lnls-ima/si-wls/model-08/simulation/magnetic/integrals-and-multipoles/mesh/Difference_trajectory_in-axis_field2_Xi=0mm_newmesh_.JPG

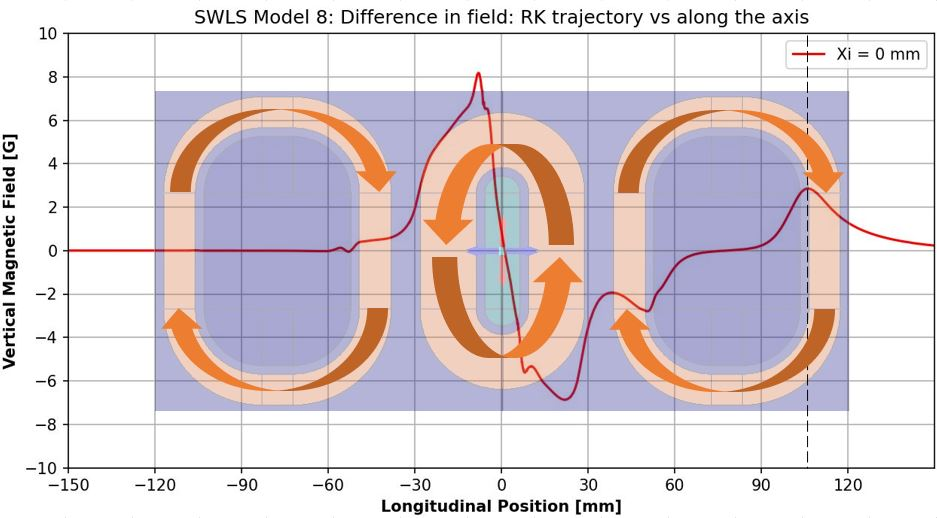
model-08/simulation/magnetic/integrals-and-multipoles/mesh/Difference_trajectory_in-axis_field2_Xi=0mm_newmesh_.JPG
