lnls-ima/si-wls/vertical-cryostat-prototypes/simulation/magnetic/geometry_prototype_centralcoil.PNG

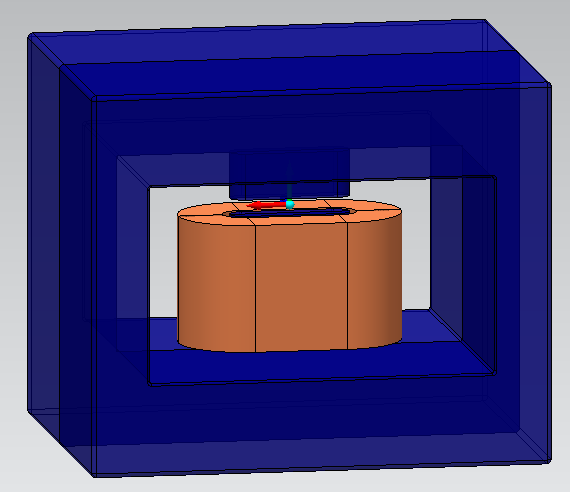
vertical-cryostat-prototypes/simulation/magnetic/geometry_prototype_centralcoil.PNG
