lnls-ima/si-wls/model-01/simulation/magnetic/SWLS_Sirius_Model1_Long_Field_I=260A.png

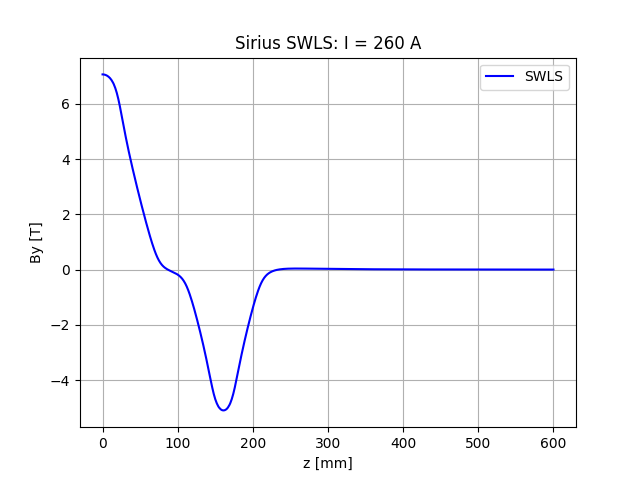
model-01/simulation/magnetic/SWLS_Sirius_Model1_Long_Field_I=260A.png
