lnls-ima/si-wls/model-02/simulation/magnetic/long_field_SWLS_Model2.JPG

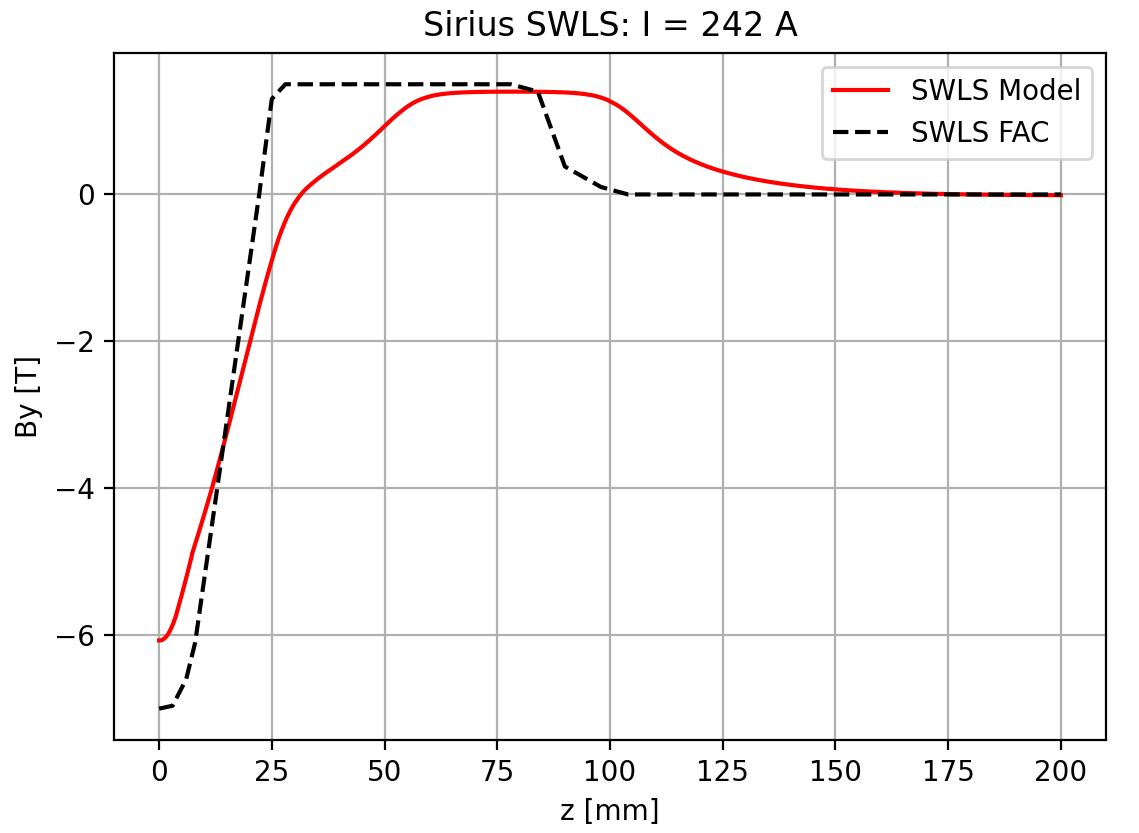
model-02/simulation/magnetic/long_field_SWLS_Model2.JPG
