lnls-ima/si-wls/vertical-cryostat-prototypes/simulation/magnetic/figures/field_prototype_centralcoil_current.PNG

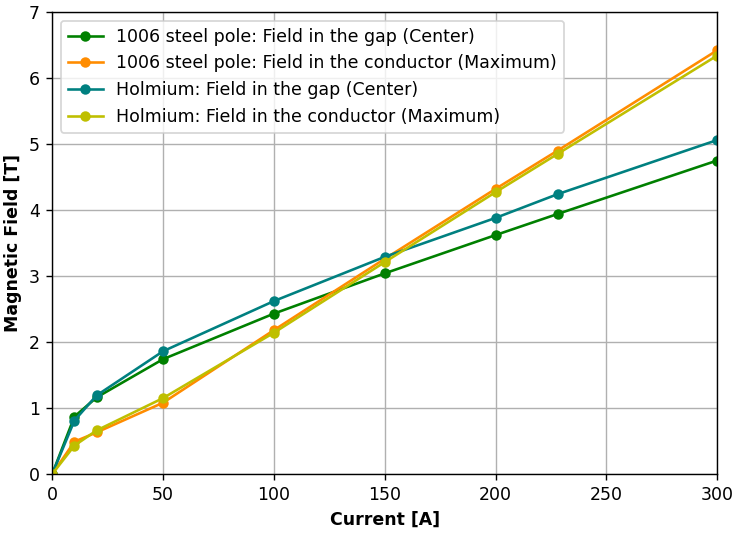
vertical-cryostat-prototypes/simulation/magnetic/figures/field_prototype_centralcoil_current.PNG
