lnls-ima/si-wls/vertical-cryostat-prototypes/simulation/magnetic/figures/field_prototype_sidecoil.PNG

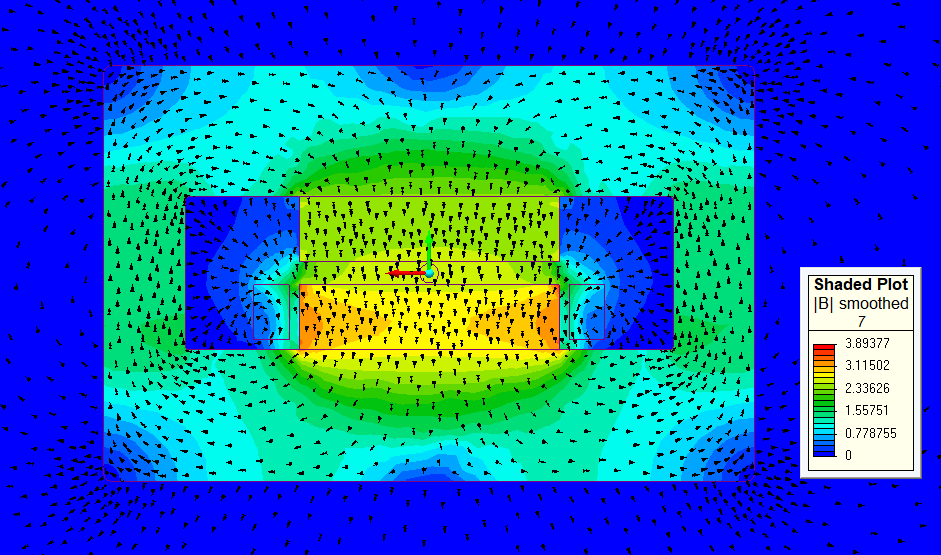
vertical-cryostat-prototypes/simulation/magnetic/figures/field_prototype_sidecoil.PNG
