lnls-ima/si-wls/vertical-cryostat-prototypes/simulation/magnetic/figures/margin_prototype_centralcoil.PNG

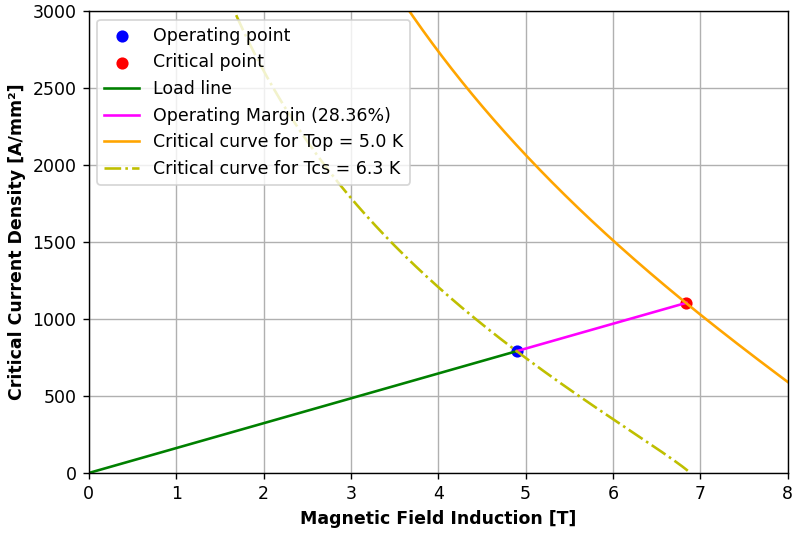
vertical-cryostat-prototypes/simulation/magnetic/figures/margin_prototype_centralcoil.PNG
