lnls-ima/si-wls/vertical-cryostat-prototypes/simulation/magnetic/figures/margin_prototype_sidecoil.PNG

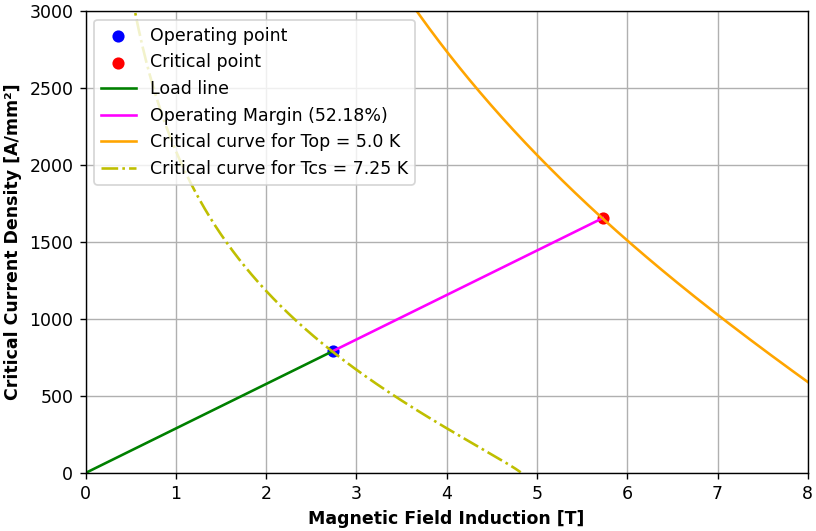
vertical-cryostat-prototypes/simulation/magnetic/figures/margin_prototype_sidecoil.PNG
