lnls-ima/si-wls/vertical-cryostat-prototypes/simulation/magnetic/figures/sme_inductance_prototype_sidecoil.PNG

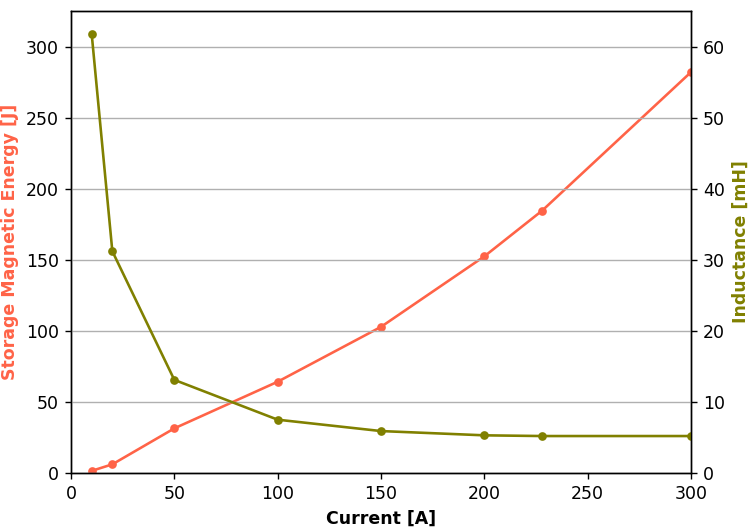
vertical-cryostat-prototypes/simulation/magnetic/figures/sme_inductance_prototype_sidecoil.PNG
