lnls-ima/si-wls/vertical-cryostat-prototypes/simulation/magnetic/geometry_prototype_sidecoil.PNG

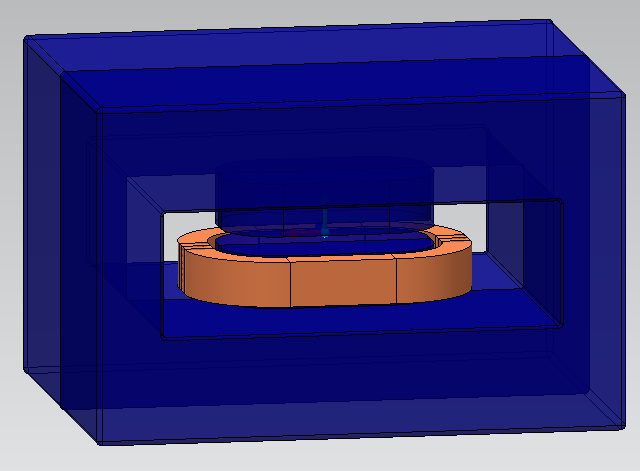
vertical-cryostat-prototypes/simulation/magnetic/geometry_prototype_sidecoil.PNG
