lnls-ima/si-wls/model-02/simulation/magnetic/SWLS_Sirius_Model2.step

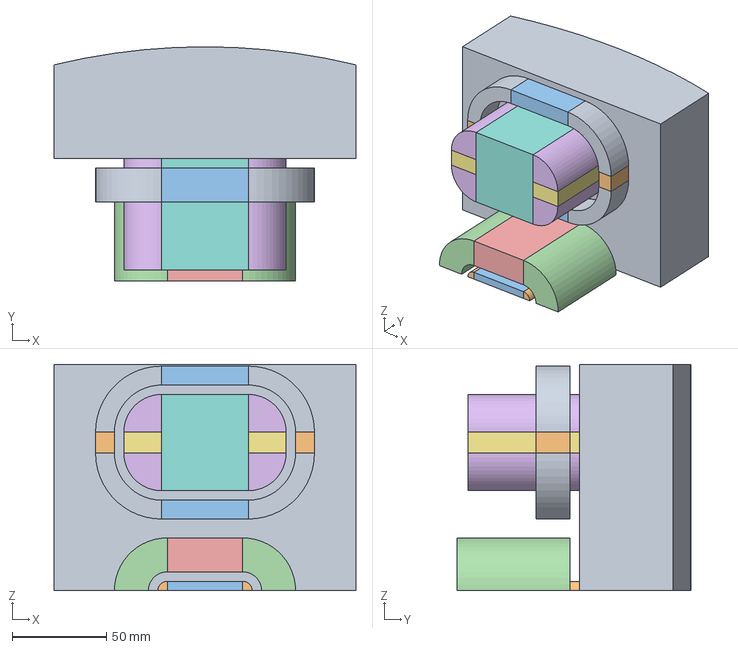
[picture p14: CAD file, 2021-10-20]
model-02/simulation/magnetic/SWLS_Sirius_Model2.step
160.0 x 124.2 x 120.0 mm
