lnls-ima/si-wls/vertical-cryostat-prototypes/simulation/magnetic/2023-02-24_SWLS_Prototype_CentralCoil_Holmium_Results.txt

I[A]	Bp[T]	Bc[T]	Fc[N]	SME[J]	L[mH]
0	0.0	0.0	0.0	0.0	0.0
10	0.81	0.43	-103	7.2	78.9
20	1.19	0.66	-230	16.4	59.5
50	1.86	1.15	-966	71.2	47.6
100	2.62	2.14	-2880	238	43.3
150	3.29	3.21	-5340	502	41.7
200	3.88	4.27	-7940	862	40.6
228	4.24	4.85	-9420	1106	40.2
300	5.06	6.34	-13120	1858	39.2
