lnls-ima/si-wls/vertical-cryostat-prototypes/simulation/magnetic/2023-02-24_SWLS_Prototype_CentralCoil_Results.txt

I[A]	Bp[T]	Bc[T]	Fc[N]	SME[J]	L[mH]
0	0.0	0.0	0.0	0.0	0.0
10	0.87	0.49	-93	4.7	53.8
20	1.16	0.63	-208	12.2	47.7
50	1.74	1.08	-808	58.4	43.7
100	2.43	2.18	-2320	218	41.9
150	3.04	3.26	-5020	476	40.8
200	3.62	4.32	-7560	830	39.9
228	3.94	4.90	-9000	1066	39.5
300	4.75	6.42	-12640	1806	38.4
