lnls-ima/si-wls/vertical-cryostat-prototypes/simulation/magnetic/2023-02-24_SWLS_Prototype_SideCoil_Results.txt

I[A]	Bp[T]	Bc[T]	Fc[N]	SME[J]	L[mH]
0	0.0	0.0	0.0	0.0	0.0
10	0.32	0.19	-23.6	1.5	61.8
20	0.64	0.38	-94.6	6.1	31.2
50	1.47	0.85	-512	31.4	13.1
100	2.06	1.20	-1156	64.2	7.5
150	2.37	1.50	-2000	102.8	5.9
200	2.61	1.83	-2980	152.4	5.3
228	2.74	2.00	-3580	184.6	5.2
300	3.02	2.46	-5220	282.0	5.2
