lnls-ima/si-wls/model-09/simulation/magnetic/2023-01-30_SWLS_Sirius_Model9.0_Results_I=228A.txt

Bp [T]		Bmax [T]	Margin [%]	HFIntBy [T.cm]
-6,6337		5,2832		24,2		-20,29
