lnls-ima/si-wls/model-08/simulation/magnetic/2022-06-03_SWLS_Sirius_Model8_Results_I=228A.txt

Bp [T]		Bmax [T]	Margin [%]	HFIntBy [T.cm]
-6,3229		5,2945		24,04		-19,78
