lnls-ima/si-wls/model-02/simulation/magnetic/2021-10-14_SWLS_Sirius_Model2_Results_I=242A.txt

Bp [T]		Bmax [T]	Margin [%]	FWHM [mm]
-6.0715		5.1781		21.31		31.8
