lnls-ima/si-wls/model-09/simulation/magnetic/updated-BHcurves/spectra-results/OPT-results/2024-05_SWLS_Flux_1x1mrad2.png

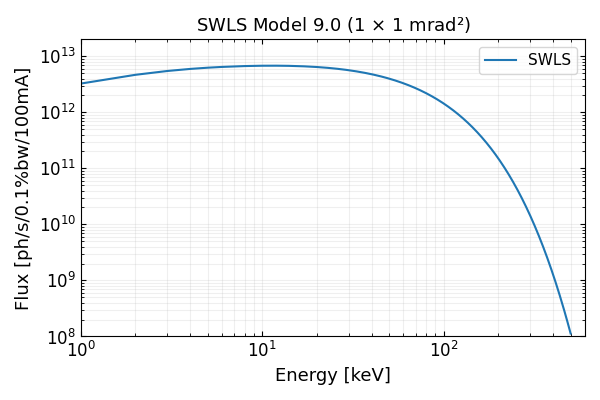
model-09/simulation/magnetic/updated-BHcurves/spectra-results/OPT-results/2024-05_SWLS_Flux_1x1mrad2.png
