lnls-ima/si-wls/model-06/simulation/spice/extraction/extraction_circuit_full_magnet_validation_time_ramp_up.asc

A1: diffschmtbuf; Vt=100m, Vh=1m, Vhigh=1, Vlow=0, Trise=1n, Tfall=1n
A2: srflop; Vhigh=1, Td=50m
A3: srflop; Vhigh=1, Td=33.3333m
A5: srflop; Vhigh=1, Td=1m
D1: diode; Dideal
D2: diode; Dlim
I1: current; PULSE(0 240 0 300 0 10)
IRq: current; 1
L_lower_left: ind; {Lside}; Rser=0 Rpar=0
L_lower_main: ind; {Lmain}; Rser=0 Rpar=0
L_lower_right: ind; {Lside}; Rser=0 Rpar=0
L_upper_left: ind2; {Lside}; Rser=0 Rpar=0
L_upper_main: ind; {Lmain}; Rser=0 Rpar=0
L_upper_right: ind; {Lside}; Rser=0 Rpar=0
R_lower_left: res; 0
R_lower_main: res; 0
R_lower_right: res; 0
R_upper_left: res; 0
R_upper_main: res; 0
R_upper_right: res; 0
Rdump1: res; 1.25
Rdump2: res; 1.25
S1: sw; MYSW
V1: voltage; 0.1
V2: voltage; 10
VRquench: voltage; PULSE(1u 20m 10m 150m 1 5)
Named nets: 0, Rquench, PSdelay, SWdelay, Qtrigger, Vdetp, Vdetn, Vthres, Vmagnetp, Vmagnetn, Vpsoutp, Qdet, VT1, VR2-3, VT3, VR3-4, VT4, VR4-5, VT5, VR5-6, VT6, VR6-7, VT7, VT2, VR1-2
.tran 310
.ic I(L1)=240 I(L2)=240
.model MYSW SW(Vt=0.9, Vh=1u, Ron=1000G, Roff=1u)
.model Dideal D(Ron=1u, Roff=1000G, Vfwd=1)
.model Dlim D(Ron=1u, Roff=1000G, Vfwd=0)
Limit output
voltage to 10V
Power-supply
actuation delay
Extraction switch
actuation delay
Normal-zone
resistance growth
Extraction switch
Validation
time
Imbalance
detection
PS turn-off
circuit
.param Lside = 12.3m
.param Lmain = 30.4m
