lnls-ima/si-wls/model-06/simulation/spice/extraction/igbt-test.asc

R1: res; 1
R2: res; 2.2
U1: FF600R12IP4
V1: voltage; PULSE(0 15 1u 1n 1n 5u 10u 2)
V2: voltage; 240
Named nets: 0, Vs, Vce
.tran 0 10u 0 10n
