lnls-ima/si-wls/model-08/simulation/spice/extraction/extraction_circuit_full_magnet_validation_time.asc

A1: diffschmtbuf; Vt=100m, Vh=1m, Vhigh=1, Vlow=0, Trise=1n, Tfall=1n
A2: srflop; Vhigh=1, Td=50m
A3: srflop; Vhigh=1, Td=33.33333m
A4: srflop; Vhigh=0, Vlow=1, Td=0
A5: srflop; Vhigh=1, Td=40m
Contactor: sw; MYSW
D2: diode; Dlim
Dfw: diode; Dideal
E1: e; table(0 0, 1n 15)
G1: g; table(0V 228A, 1nV 0A)
IRq: current; 1
L_lower_left: ind; 14m; Rser=0 Rpar=0
L_lower_main: ind; 34m; Rser=0 Rpar=0
L_lower_right: ind; 14m; Rser=0 Rpar=0
L_upper_left: ind2; 14m; Rser=0 Rpar=0
L_upper_main: ind; 34m; Rser=0 Rpar=0
L_upper_right: ind; 14m; Rser=0 Rpar=0
R_lower_left: res; 0
R_lower_main: res; 0
R_lower_right: res; 0
R_upper_left: res; R=V(Rquench)
R_upper_main: res; 0
R_upper_right: res; 0
Rdump1: res; 1.25
Rdump2: res; 1.25
Rg1: res; 2.2
U1: FF600R12IP4
V1: voltage; 0.1
V2: voltage; 10
VRquench: voltage; PULSE(1u 20m 10m 150m 1 5)
Named nets: 0, Rquench, PSdelay, SWdelay, Qtrigger, Vdetp, Vdetn, Vthres, Vmagnetp, Vmagnetn, Vpsoutp, Qdet, VT2, VT3, VT4, VT5, VT6, VT1, VT7, IGBTdriver, VE1
.tran 300m
.ic I(L_upper_left)=Iop I(L_lower_left)=Iop I(L_upper_main)=Iop
.ic I(L_lower_main)=Iop I(L_upper_right)=Iop I(L_lower_right)=Iop
.model MYSW SW(Vt=0.9, Vh=1u, Ron=1000G, Roff=1u)
.model Dideal D(Ron=1u, Roff=1000G, Vfwd=1)
.model Dlim D(Ron=1u, Roff=1000G, Vfwd=0)
Limit output
voltage to 10V
Power-supply
actuation delay
Contactor
actuation delay
Normal-zone
resistance growth
Extraction switch
Validation
time
Imbalance
detection
PS turn-off
circuit
IGBT driver
Current source
.param Iop = 228
.options reltol=0.002
