lnls-ima/si-wls/model-06/simulation/spice/extraction/rdump_vout_lim.asc

A1: diffschmtbuf; Vt=100m, Vh=1m, Vhigh=1, Vlow=0, Trise=1n, Tfall=1n
A2: srflop; Vhigh=1, Td=50m
A5: srflop; Vhigh=1, Td=1m
D1: diode; Dideal
D2: diode; Dlim
G1: g; table(0V 240A, 1nV 0A)
IRq: current; 1
L1: ind; 0.055; Rser=0 Rpar=0
L2: ind; 0.055; Rser=0 Rpar=0
R2: res; R=V(Rquench)
Rdump1: res; 1.25
Rdump2: res; 1.25
S1: sw; MYSW
V1: voltage; 0.1
V2: voltage; 10
VRquench: voltage; PULSE(1u 20m 10m 150m 1 5)
Named nets: 0, Rquench, PSdelay, SWdelay, Qtrigger, Vdetp, Vdetn, Vthres, Vmagnetp, Vmagnetn, Vpsoutp
.tran 300m
.ic I(L1)=240 I(L2)=240
.model MYSW SW(Vt=0.9, Vh=1u, Ron=1000G, Roff=1u)
.model Dideal D(Ron=1u, Roff=1000G, Vfwd=1)
.model Dlim D(Ron=1u, Roff=1000G, Vfwd=0)
Limit output
voltage to 10V
PS turn-off
circuit
Imbalance
detection
Power-supply
actuation delay
Extraction switch
actuation delay
Normal-zone
resistance growth
Extraction switch
