lnls-ima/si-wls/(commit log)

2021-10-20 Renaming folders
    [SWLS_Sirius_Model2.step]
2021-12-14 Supercon Wire Model added
2022-01-06 Quench: Create Copper class to hold material data
    Create Copper class in materials.py module to hold copper data.
    At the moment, class only contains thermal conductivity data for
    different RRR.
2022-01-20 Quench: Consider Nb-Ti area in engineering current density
    Fix J in quench propagation velocity calculation to be:
    Iop / (copper_area + nbti_area)
    [detection.py]
2022-01-25 Fixed bug on copper resistivity plot, included gitignore and comparisons between specific heat for Copper and NbTi from different references. Included also propagation velocity estimations script for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
    [materials.py]
2022-01-26 Improvement of thermal properties analysis and simulations. Inclusion of detection analysis for SWLS V5.0
    [copper_specific_heat_copper_org.csv, nb35ti65_recrystalized_thermal_conductivity_bychkov.csv, nb35ti65_thermal_conductivity_bychkov2.csv, nb45ti55_recrystalized_thermal_conductivity_bychkov.csv, nb45ti55_thermal_conductivity_bychkov.csv, nbti_specific_heat_davide.csv]
2022-01-27 Refactor wire properties calculations to class SCWire
2022-01-27 Quench: Add line geometry option to quench.py
    -Add line geometry for quench resistance calculation.
    -Fix composite heat capacity by considering that the Nb-Ti
    contribution is added to the copper contribution to heat
    capacity, although considering the area fraction of each
    material individually. This calculation should be further
    improved in a next commit.
    -Add MIITS table data to be used by future commits for
    hot-spot estimation.
    [quench.py]
2022-02-01 Update quench simulation code
    - Adapt code to use new materials' data
    - Change code to always use composite properties
    - Generate more output plots
2022-02-03 quench.py: Add hot-spot function and Coil class
    Hot-spot calculation function calculates the maximum temperature
    rise considering only the area of copper as conducting, i.e.,
    copper area and resistivity, but consider the heat dissipation
    in both copper and niobium-titanium, i.e., the sum of copper
    and niobium-titanium heat capacities as described in
    M. S. McAshan, "MIITS Integrals for Copper and Nb - 46.5 wt% Ti",
    February 10, 1988.
2022-02-12 materials.py: Add average properties from T1 to T2
    - Add functions to calculate the average material propertie value from an initial
    temperature T1 to a final temperature T2.
    - Add these average properties to the SCWire class.
2022-02-12 Add some quench detection analysis scripts
    - Add analysis for model 03 and 04.
    - Add a new script for model 05 (analysis 3), which incorporates
    the average material properties from Top to Tjoule, instead of
    calculating them at Tjoule.
2022-02-22 quench.py: Limit power supply max output voltage
    - Limit power supply maximum output voltage.
    - Add more plots:
    Voltage at coil terminals
    Coil inductive voltage
    Voltage across normal zone (different from quench voltage, which
    just considers the resistive contribution)
2022-03-11 Quench: Separate detection, validation and actuation times in simulation
    Changes in simulation:
    - Calculate detection time based on quench voltage growth and specified detection threshold.
    - Add specified validation and actuation delays after detection.
2022-03-11 Quench: Add copper magnetoresistivity calculation
2022-03-21 Inductance vs Current Models 6 and 7
2022-05-03 quench.py: Add freewheeling diode and power supply delay
    Add to quench simulation script:
    - Freewheeling diode forward voltage during discharge after power
    supply is disabled
    - Power supply delay to disable after validation time ends
    OBS: Power supply delay runs in parallel with protection switch
    delay, but both start counting after detection happens and the
    validation time expires.
2022-05-04 SWLS Compilate Data for optimization
    [SWLS_Compilate_Data.csv]
2022-05-25 MAGNET scripts updated
2022-06-02 Include inductance on parameters dictionary, add function to calculate power dissipation on quenched zone, include script to compare MIITS from different designs
2022-06-02 Included inductance in function of current on quench analysis
2022-06-02 Fix bugs on quench.py
    [quench.py]
2022-06-02 Include protection circuit spice model for model 6
2022-06-06 Quench: Fix quench.py script
    Initialize variable 't_resp_ps' to infinity. This variable is updated to
    the correct power supply disable time when the quench event is
    detected, similarly to what happens to the 't_resp' variable, which
    stores the protection switch actuation time.
    [quench.py]
2022-06-06 Quench:Add script to analyze protection for I=300A
    Add script to compare hot-spot temperature estimates for
    I_op = 240 A and I_op = 300 A.
    The effect of increasing the voltage across the dump resistance
    is also analyzed for both scenarios.
2022-06-07 Quench: Add magnetoresistivity to quench simulation script
2022-06-08 Included v8 detection analysis, fix ill-condition for near-zero field magnetoresistivity for copper, refactor spice directory for model 6 and included new spice models
    [materials.py, v8_detection_analysis.py]
2022-06-08 Included IGBT Spice model and simulation circuit for it
2022-06-09 Included IGBT model into extraction circuit
2022-06-10 Incorporated magnetoresistivity of copper into calc_resistivity
2022-06-15 New extraction circuit for model 8
2022-06-15 Quench: Add script for extraction resistor analysis
2022-06-23 Quench: Improve dump resistor analysis script
    - Include plots for voltage unbalance between
    left and right resistor sides.
    - Improve plots look and information.
2022-07-07 Quench: Improve dump resistor analysis
    - Add plots comparing the maximum number of failures
    supported by each dump resistor configuration within
    the voltage margins specified for the dump resistance.
    [v8_dump_analysis.py]
2022-07-28 Multipoles and integrals over trajectory analysis added
    [SWLS_Integrals_Multipoles_Analysis.xlsb.xlsx]
2022-08-08 Include comparison between MIITS table data and estimation based on integral of materials properties
2022-08-29 Integrals and multipoles analysis updated
    [SWLS_Data_FabErrors.xlsx, SWLS_Data_Mesh_DiffCurrents.xlsx, SWLS_Integrals_Multipoles_Analysis.xlsb.xlsx]
2023-02-27 Vertical Cryostat Prototype Magnetic Simulations
2024-06-11 Update SWLS magnetic simulations
2026-10-16 Add Streched Wire measurements 16/10
2026-10-28 Add measurement with rampup currents during rampdown
2026-10-28 Add currents which cancels the integrals for ramp-up and ramp-down
2026-10-28 Add measurement with ramp-up current
2026-11-06 Add Ramp-up currents after a ramp-down (with remanent field)
